jkross/Arduino/Eagle/Silkscreen/CenteredMonogram.png

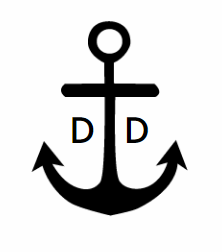
Eagle/Silkscreen/CenteredMonogram.png
