jkross/Arduino/Eagle/Silkscreen/CenteredMonogramOnly.bmp

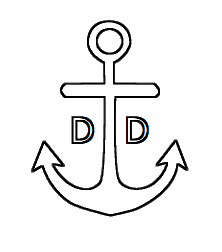
Eagle/Silkscreen/CenteredMonogramOnly.bmp
