jkross/Arduino/Eagle/Silkscreen/DKDMonogram.png

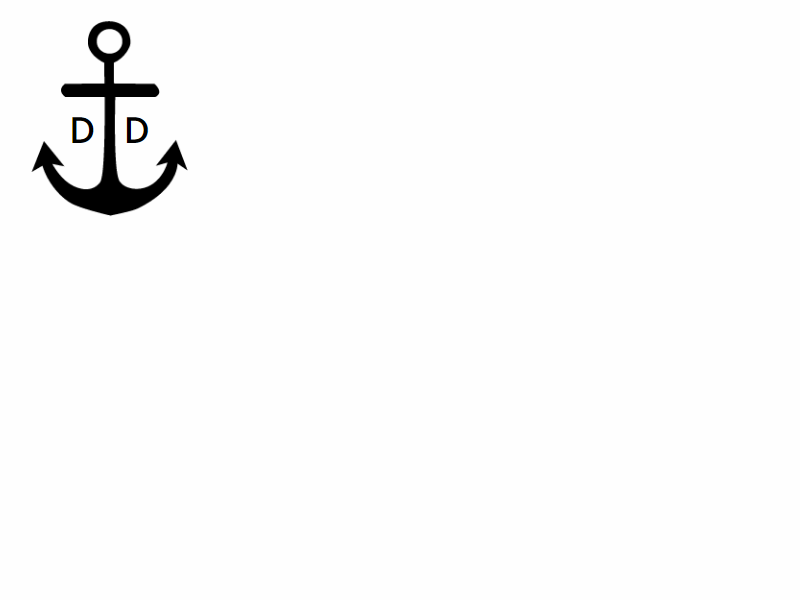
Eagle/Silkscreen/DKDMonogram.png
