jkross/Arduino/Eagle/Silkscreen/qr.jpg

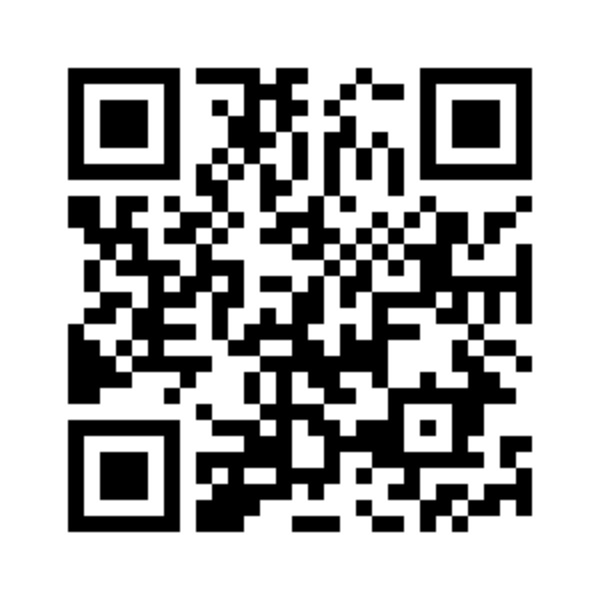
Eagle/Silkscreen/qr.jpg
