jkross/Arduino/Eagle/Silkscreen/silk.bmp

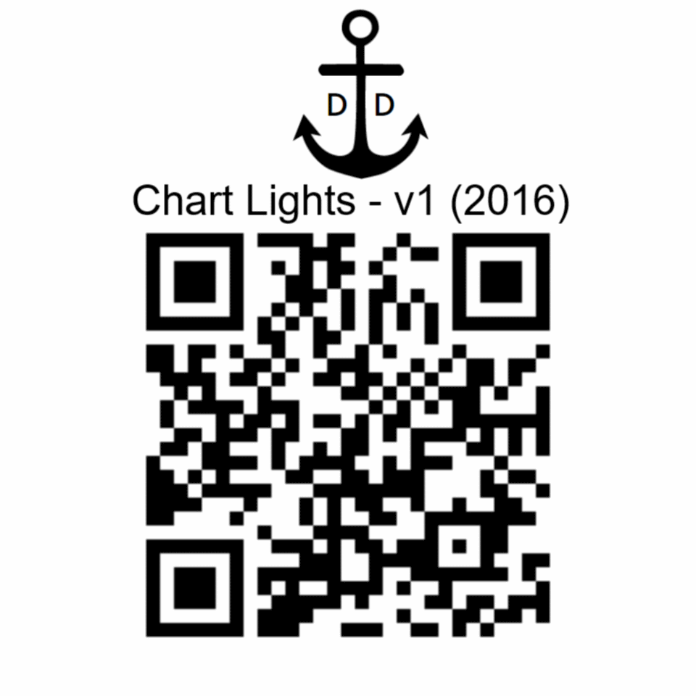
Eagle/Silkscreen/silk.bmp
