jkross/Arduino/Eagle/Silkscreen/silkposn.bmp

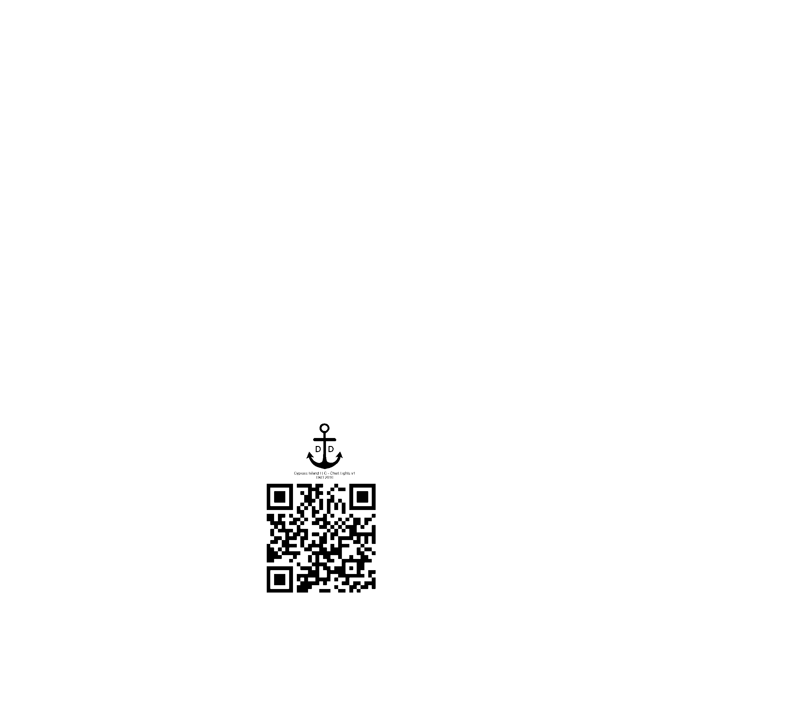
Eagle/Silkscreen/silkposn.bmp
