jkross/Arduino/Eagle/Silkscreen/CenteredMonogramOnly.stl

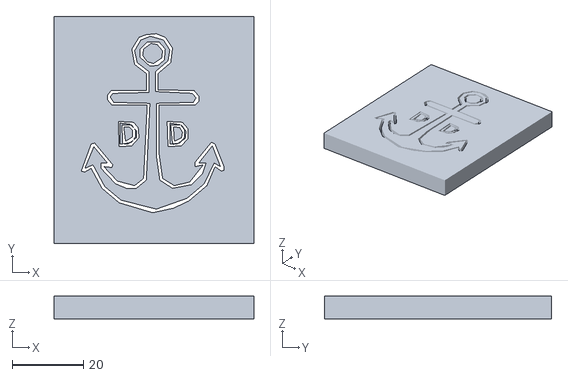
[picture p7: CAD file, 2016-10-16]
Eagle/Silkscreen/CenteredMonogramOnly.stl
56.1 x 63.8 x 6.40
