jkross/Arduino/SketchUp/Arduino_Jack.stl

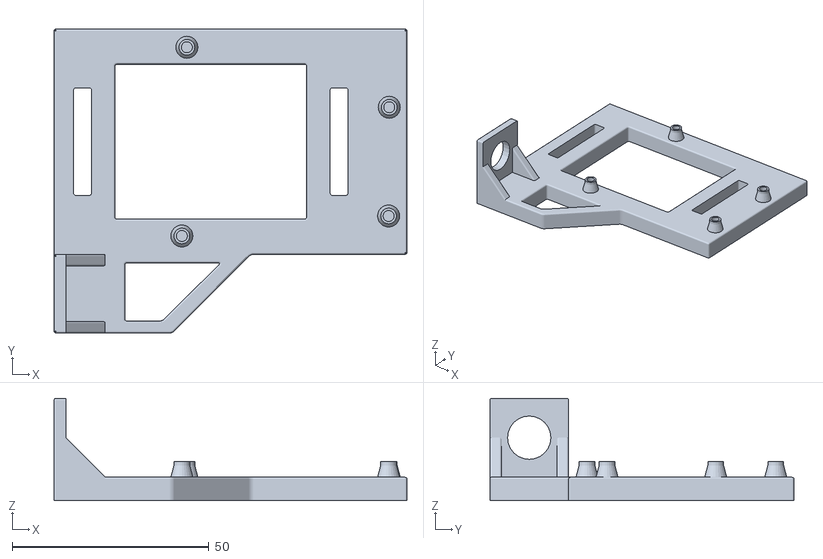
[picture p8: CAD file, 2016-10-16]
SketchUp/Arduino_Jack.stl
89.6 x 77.3 x 26.0
