jkross/Arduino/Eagle/Silkscreen/CenteredMonogram.stl

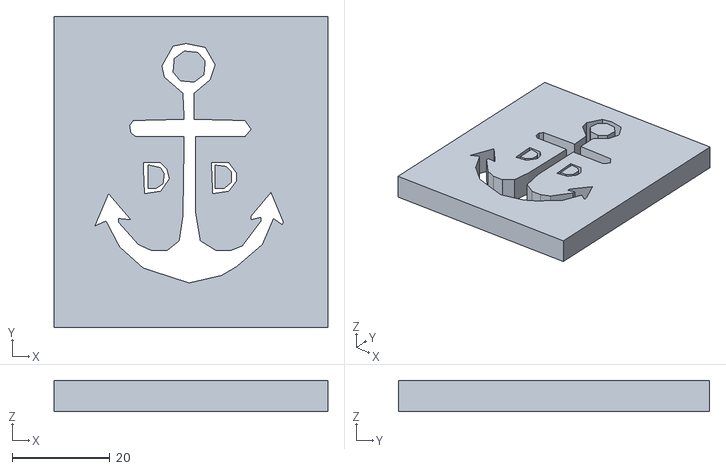
[picture p9: CAD file, 2016-10-16]
Eagle/Silkscreen/CenteredMonogram.stl
56.1 x 63.8 x 6.40
