jkross/Arduino/SketchUp/Arduino_Jack_fixed.stl

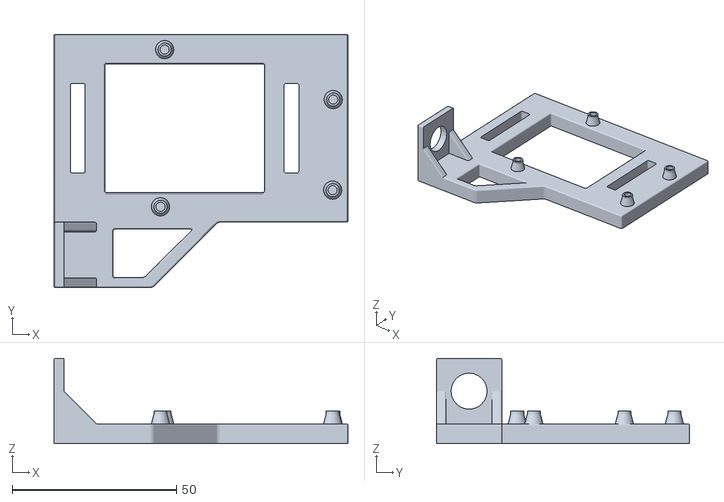
[picture p10: CAD file, 2016-10-16]
SketchUp/Arduino_Jack_fixed.stl
89.6 x 77.3 x 26.0
