jkross/Arduino/SketchUp/LED Holder.stl

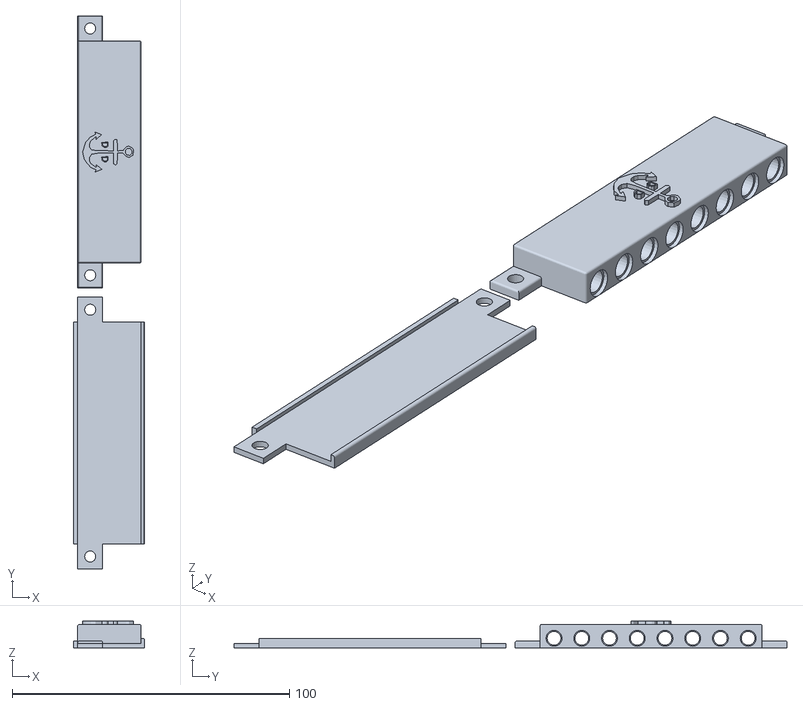
[picture p11: CAD file, 2016-10-16]
SketchUp/LED Holder.stl
25.5 x 199.4 x 9.64
