jkross/Arduino/(list of files, cad)

Other CAD files:
SketchUp/LED Holder_fixed.stl
SketchUp/Arduino_Jack.skp
SketchUp/LED Holder.skp
SketchUp/LED.skp
