jkross/Arduino/Eagle/chart3.brd

## EAGLE design Eagle/chart3.brd (2016-10-16)

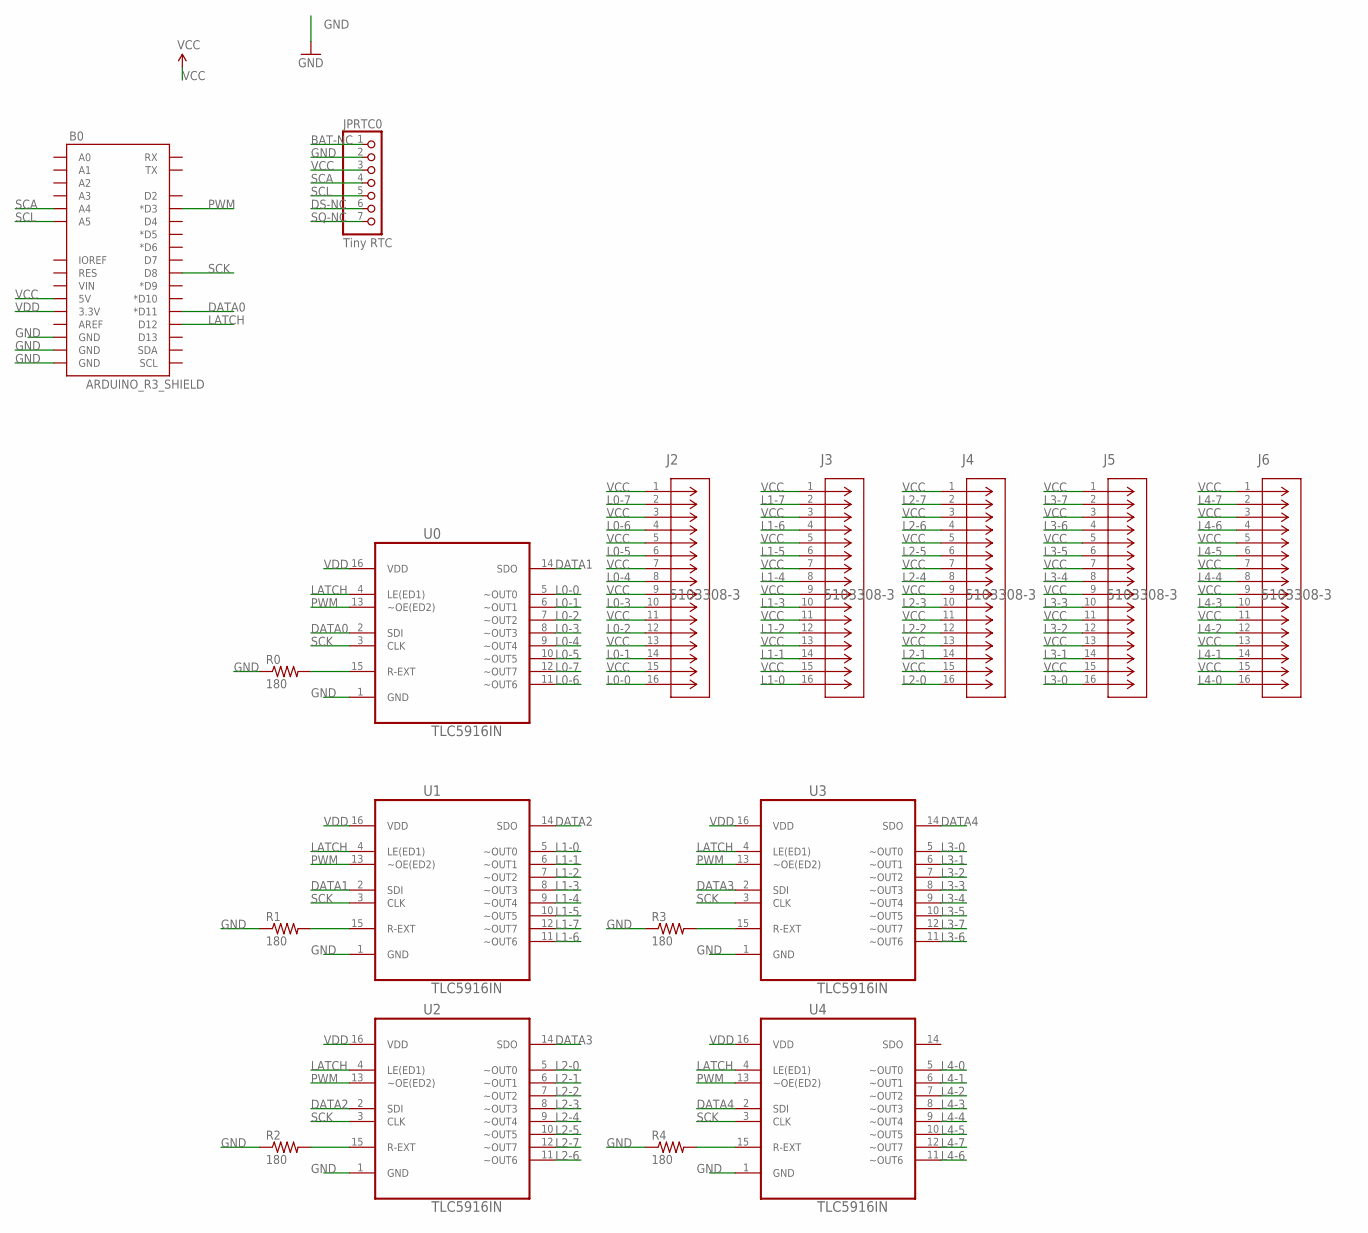
[picture p12: schematic chart3.sch]

Parts:
B0: ARDUINO_R3_SHIELD; UNO_R3_SHIELD
J2, J3, J4, J5, J6: 5103308-3; CON16_2X8_S4
JPRTC0: Tiny RTC; 1X07
R0, R1, R2, R3, R4: 180; AXIAL-0.4
U0, U1, U2, U3, U4: TLC5916IN; DIP254P762X508-16

Connections:
BAT-NC: JPRTC0.1
DATA0: B0.D11 (*D11), U0.2 (SDI)
DATA1: U0.14 (SDO), U1.2 (SDI)
DATA2: U1.14 (SDO), U2.2 (SDI)
DATA3: U2.14 (SDO), U3.2 (SDI)
DATA4: U3.14 (SDO), U4.2 (SDI)
DS-NC: JPRTC0.6
GND: B0.GND@0 (GND), B0.GND@1 (GND), B0.GND@2 (GND), JPRTC0.2, R0.P$1 (1), R1.P$1 (1), R2.P$1 (1), R3.P$1 (1), R4.P$1 (1), U0.1 (GND), U1.1 (GND), U2.1 (GND), U3.1 (GND), U4.1 (GND)
L0-0: J2.16, U0.5 (~OUT0)
L0-1: J2.14, U0.6 (~OUT1)
L0-2: J2.12, U0.7 (~OUT2)
L0-3: J2.10, U0.8 (~OUT3)
L0-4: J2.8, U0.9 (~OUT4)
L0-5: J2.6, U0.10 (~OUT5)
L0-6: J2.4, U0.11 (~OUT6)
L0-7: J2.2, U0.12 (~OUT7)
L1-0: J3.16, U1.5 (~OUT0)
L1-1: J3.14, U1.6 (~OUT1)
L1-2: J3.12, U1.7 (~OUT2)
L1-3: J3.10, U1.8 (~OUT3)
L1-4: J3.8, U1.9 (~OUT4)
L1-5: J3.6, U1.10 (~OUT5)
L1-6: J3.4, U1.11 (~OUT6)
L1-7: J3.2, U1.12 (~OUT7)
L2-0: J4.16, U2.5 (~OUT0)
L2-1: J4.14, U2.6 (~OUT1)
L2-2: J4.12, U2.7 (~OUT2)
L2-3: J4.10, U2.8 (~OUT3)
L2-4: J4.8, U2.9 (~OUT4)
L2-5: J4.6, U2.10 (~OUT5)
L2-6: J4.4, U2.11 (~OUT6)
L2-7: J4.2, U2.12 (~OUT7)
L3-0: J5.16, U3.5 (~OUT0)
L3-1: J5.14, U3.6 (~OUT1)
L3-2: J5.12, U3.7 (~OUT2)
L3-3: J5.10, U3.8 (~OUT3)
L3-4: J5.8, U3.9 (~OUT4)
L3-5: J5.6, U3.10 (~OUT5)
L3-6: J5.4, U3.11 (~OUT6)
L3-7: J5.2, U3.12 (~OUT7)
L4-0: J6.16, U4.5 (~OUT0)
L4-1: J6.14, U4.6 (~OUT1)
L4-2: J6.12, U4.7 (~OUT2)
L4-3: J6.10, U4.8 (~OUT3)
L4-4: J6.8, U4.9 (~OUT4)
L4-5: J6.6, U4.10 (~OUT5)
L4-6: J6.4, U4.11 (~OUT6)
L4-7: J6.2, U4.12 (~OUT7)
LATCH: B0.D12, U0.4 (LE(ED1)), U1.4 (LE(ED1)), U2.4 (LE(ED1)), U3.4 (LE(ED1)), U4.4 (LE(ED1))
unnamed: R1.P$2 (2), U1.15 (R-EXT)
unnamed: R2.P$2 (2), U2.15 (R-EXT)
unnamed: R3.P$2 (2), U3.15 (R-EXT)
unnamed: R4.P$2 (2), U4.15 (R-EXT)
unnamed: R0.P$2 (2), U0.15 (R-EXT)
PWM: B0.D3 (*D3), U0.13 (~OE(ED2)), U1.13 (~OE(ED2)), U2.13 (~OE(ED2)), U3.13 (~OE(ED2)), U4.13 (~OE(ED2))
SCA: B0.A4, JPRTC0.4
SCK: B0.D8, U0.3 (CLK), U1.3 (CLK), U2.3 (CLK), U3.3 (CLK), U4.3 (CLK)
SCL: B0.A5, JPRTC0.5
SQ-NC: JPRTC0.7
VCC: B0.5V, J2.1, J2.3, J2.5, J2.7, J2.9, J2.11, J2.13, J2.15, J3.1, J3.3, J3.5, J3.7, J3.9, J3.11, J3.13, J3.15, J4.1, J4.3, J4.5, J4.7, J4.9, J4.11, J4.13, J4.15, J5.1, J5.3, J5.5, J5.7, J5.9, J5.11, J5.13, J5.15, J6.1, J6.3, J6.5, J6.7, J6.9, J6.11, J6.13, J6.15, JPRTC0.3
VDD: B0.3.3V, U0.16 (VDD), U1.16 (VDD), U2.16 (VDD), U3.16 (VDD), U4.16 (VDD)

Board: 2 copper layers, 17 parts (0 on the bottom side), 58 nets, no tracks yet.
