jkross/Arduino/Arduino/morseTimer.cpp

//
//  Class to manage LED patterns for a Morse code blinking sequence
//
#ifndef WIN32
#include <Arduino.h>
#endif // !WIN32
#include "debug.h"
#include "morseTimer.h"
#include "morseLightList.h"
#include "morse.h"
#include "lfsr.h"


morseTimer::morseTimer(morseLightDesc *mldp)
	: timer(0)
{
	_state_char = 0;
	_state = 0;
	_mldp = mldp;
}

bool
morseTimer::init(ticks_t start, ledDriver* driver)
{
	_driver = driver;
	ticks = start;
	_mchar = getCharDesc(_state_char);
	return true;									// we set ticks, request scheduling
}


//
//  Index into the compressed Morse table for a given upper-case character
//
int
morseTimer::index(char c)
{
	// Table is organized as space, numerals, letters
	if (c == ' ') { return 0; }
	if (c >= '0' && c <= '9') { return 1 + c - '0'; }
	if (c >= 'A' && c <= 'Z') { return 11 + c - 'A'; }
	return 0;
}

//
// Get the Morse character description for the current character (defined by state_char)
//
const morseChar *
morseTimer::getCharDesc(int state_char) {
	int idx = index(_mldp->letters[state_char]);
	const morseChar *mcp = &MorseMap[idx];
#ifdef WIN32
	printf("state %2d char: %c, index: %2d\n", state_char, _mldp->letters[state_char], idx);
#endif // WIN32
	return mcp;
}


//
//  Decode the compressed tables to get the step duration in MORSE_UNITs
//
int
morseTimer::decodeStateDur(uint8_t state) {
	int pair = state / 2;			// there are two states in each pair, beginning with the on, then off duration
	int half = state % 2;
	morseCharOnOff onOff = _mchar->delays[pair];
	return half == 0 ? onOff.on : onOff.off;
}

//
//	Return duration in milliseconds for specified state
//
uint16_t
morseTimer::stepDuration(int state, int fuzz) {
	uint16_t duration = MORSE_UNIT * decodeStateDur(state);
	return duration;
}


//
//  Adavance the state machine
//
void
morseTimer::advanceState(void)
{
	_state++;											// next delay pattern
	if (decodeStateDur(_state) == MORSE_END) {
		_state = 0;
		_state_char++;									// next character
		if (_mldp->letters[_state_char] == '\0') {
			_state_char = 0;							// start with first letter again
		}
		_mchar = getCharDesc(_state_char);				// set the new character's Morse description
	}
}

//
//  Called when the timer expires.
//  * set LED state
//  * calculate next time to be invoked
//
//  Always request a next time, cycling through pattern indefinitely
//  For Morse LED patterns we don't randomize with fuzz
//
bool
morseTimer::invoke(ticks_t now, int fuzz)
{
	do {
		int bitval = (_state & 0x1) ^ 0x1;		// alternate between on/off
		_driver->set(_mldp->pin, bitval);		// start off setting the bit
		ticks_t xdur = stepDuration(_state, fuzz);
		ticks = ticks + xdur;					// our next timer
#ifdef WIN32
		printf("Pin: %2d %s %7d\n", _mldp->pin, bitval ? "on" : "off", xdur);
#endif // WIN32
		advanceState();							// advance the state machine
	} while (isExpired(now));						// catch up if we need to
	return true;								// schedule again
}

//
//  Load up all the Morse LED values from our table
//  	NB: although we don't fuzz the timing of Morse patterns
//  	we do fuzz the start time for a "soft" start
//
void
morseTimer::loadPatterns(scheduler* schedp, ledDriver *driverp, lfsr* lfsrp, ticks_t now)
{
	for (int i = 0; i < NUM_MORSE_LIGHT_LIST; i++) {
		morseTimer *light = new morseTimer(&morseLightList[i]);				// create the timer objectd
		ticks_t startOffset = lfsrp->nextStartOffset();						// compute random start time
		if (light->init(now + startOffset, driverp)) {
			schedp->queueTimer(light);										// queue @ start time
		}
	}
}
