jkross/Arduino/Arduino/patterns.h

#pragma once

typedef uint16_t seq_t;
//typedef uint8_t pin_t;

#define PATTERN_SEQ_LEN 2
struct pattern {
  // pin_t pin;
  // on, followed by off
  seq_t sequence[PATTERN_SEQ_LEN];
};

#define LIGHT_DESC_NO_BLINK 0xFF
struct lightDesc {
	uint8_t	seqId;
};
