jkross/Arduino/(commit log)

2016-10-16 new part from Digikey
    [Eagle.sch]
2016-10-16 remove EDA
    [Eagle.sch]
