jkross/Arduino/(notices)

Notices in the files:
parts and their libraries:
SparkFun-Boards: Licensing: Creative Commons ShareAlike 4.0 International - https://creativecommons.org/licenses/by-sa/4.0
510308: COPYRIGHT: Copyright (C) 2015 Accelerated Designs. All rights reserved
